kwlyon/physics-demos/torque-spool-demo/output/pdf/torque_spool_physics_walkthrough.pdf

Torque-Spool Demonstration | Physics Walkthrough

## Why Does the Spool Reverse Direction?

A Newton-Euler walkthrough for the spool-paradox demonstration

Tire-on outer diameter: D = 185.0 mm | | | rolling radius: R = 92.5 mm

### 1. System, forces, and sign conventions

A cord is tangent to an inner winding cylinder of radius r while the spool rolls on outer tires of radius R. The cord is pulled with tension T at angle θ above the horizontal. The direction of the spool’s acceleration changes at a critical angle θc.

Take +x to the right, positive angular acceleration α counterclockwise, and let the static-friction force f be signed. The leftward friction arrow below is the direction obtained for the usual geometry; the equations themselves determine its sign.

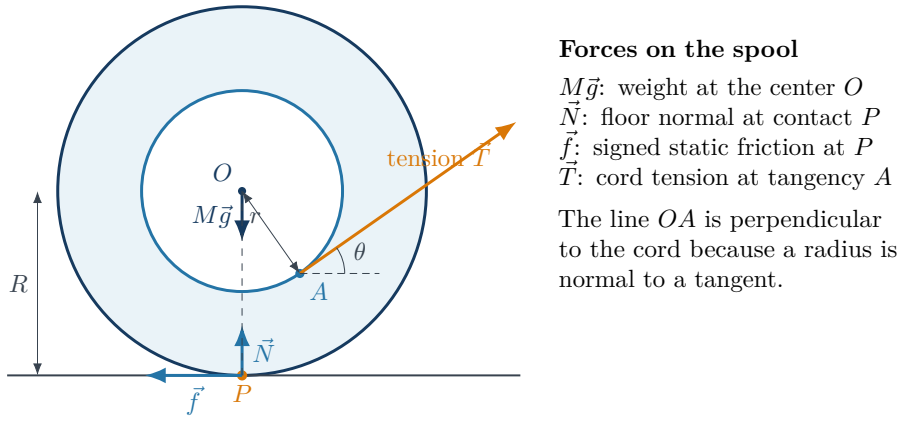
[picture p2: figure]
tension T⃗; Forces on the spool; M⃗g: weight at the center O N⃗ : floor normal at contact P ⃗f: signed static friction at P T⃗: cord tension at tangency A; The line OA is perpendicular to the cord because a radius is normal to a tangent.

Rolling constraint: with the signs chosen above, rolling without slipping requires

a = −Rα.

### 2. Newton’s laws and the rolling acceleration

Let M be the total spool mass and I its moment of inertia about O. Newton’s second law in the horizontal and vertical directions gives

∑︂Fx : | T cos θ + f = M a, | (1)
∑︂Fy : | N + T sin θ − Mg = 0. | (2)

The vertical acceleration is zero while the spool stays on the floor, so

| N = Mg − T sin θ. | (3)

Now sum torques about the center O. The tension is tangent to radius r, and friction acts with lever arm R. With counterclockwise torque positive,

∑︂τO = rT + Rf = Iα. | (4)

Use the rolling condition α = −a/R and solve Eq. (1) for f:

| f = M a − T cos θ.

Substitution into Eq. (4) gives

rT + R (M a − T cos θ) = −

| I R
a,

T (r − R cos θ) + a

(︃

| MR + I R
)︃
| = 0.

Define two dimensionless quantities,

ρ =

r
R
, | κ =
| I MR² .

The acceleration and the signed friction force are then

| a = T M cos θ − ρ 1 + κ | (5)

f = −T

ρ + κ cos θ
1 + κ
. | (6)

Equation (5) contains the reversal directly. Because T /M and 1 + κ are positive, only cos θ − ρ determines the sign of a:

Condition Sign of a | Motion from rest
cos θ > ρ | a > 0 | accelerates toward +x
cos θ = ρ | a = 0 | transition point
cos θ < ρ | a < 0 | accelerates toward −x
a = 0 | =⇒ | cos θc =

r
R

## =⇒ θc = cos⁻¹

(︄

r
R

)︄

### 3. Geometry of the critical angle

The same result has a useful geometric interpretation. At the transition, extend the cord’s line of action backward from the tangency point A. It passes through the floor-contact point P. The tension vector itself still begins at A, its physical point of application.

In right triangle OAP,

OP = R, OA = r.

Since ∠OP A = 90◦ − θc,

r
R

= sin(90◦ − θc) = cos θc.

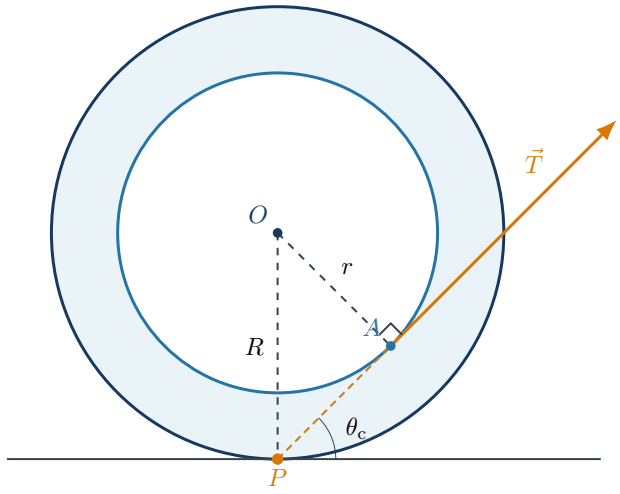
[picture p3: figure]

## θc = cos⁻¹

(︄

r
R

)︄

## = cos⁻¹

⎛
⎝

2r
D

⎞
⎠ .

### 4. Numerical check for the 45-degree insert

For the installed TPU tires,

D = 185.0 mm, R =

D
2

= 92.5 mm.

The 45-degree insert has r = 65.407 mm, so

θc = cos⁻¹

(︃

| 65.407 mm 92.5 mm )︃

= 45.00◦

For cord diameter d, the first-layer centerline radius is

reff = r +

d
2

A 2.0 mm cord gives reff = 66.407 mm and θc,ef f ≈ 44.12◦ .

### 5. Static-friction condition for no slipping

Terminology. The relevant material property is the coefficient of static friction µs. The coefficient of restitution e describes energy retained in an impact or bounce and does not set the rolling-slip threshold in this slow demonstration.

Coulomb static friction requires
|f| ≤ µsN. | (7)

Using Eqs. (3) and (6), the general required coefficient is

µreq(θ) = T |ρ + κ cos θ|
(1 + κ) (Mg − T sin θ)
. | (8)

This formula applies while N > 0, or equivalently T sin θ < Mg.

At the critical angle, ρ = cos θc. The dependence on the moment of inertia cancels:

|fc| = T cos θc, Nc = Mg − T sin θc.

Let the dimensionless pull be q = T /(Mg). The critical-angle slip test becomes

µreq,c =

q cos θc
1 − q sin θc

(9)

q ≤ qmax =

µs
cos θc + µs sin θc
. | (10)

How much do the larger angles matter?

The table uses a representative pull q = 0.20, meaning T = 0.20Mg. It is a dimensionless illustration, not a measurement of the apparatus.

θc | Nc/(Mg) |fc|/(Mg) µreq,c
30◦ | 0.900 | 0.173 0.192
40◦ | 0.871 | 0.153 0.176
45◦ | 0.859 | 0.141 0.165
50◦ | 0.847 | 0.129 0.152
60◦ | 0.827 | 0.100 0.121

From 30◦

to 60◦
, the normal force falls only from 0.900Mg to 0.827Mg (about an 8% change). Meanwhile, the horizontal tension that friction must balance falls more strongly. The required friction coefficient therefore decreases, from about 0.192 to 0.121 in this example. Larger critical angles slightly unload the tire, but they do not make slip more likely here; the friction margin improves.

For any planned pull, compute q = T /(Mg) and compare Eq. (9) with the available µs, or use
Eq. (10) to find the largest no-slip pull.

### 6. Suggested classroom procedure

1. Install the desired insert and both TPU tires. Use a thin cord in one neat layer.
2. Measure the spool mass M and, if quantitative testing is desired, measure the pull T with a spring scale or force sensor.
3. Pull slowly at an angle clearly below the label and note the acceleration direction.
4. Repeat clearly above the label and observe the reversal.
5. Approach the transition in small angular steps. Compare the result with

θc = cos⁻¹

(︃

r
R

)︃
,

or replace r by r + d/2 when correcting for cord thickness.

6. Evaluate the no-slip margin using

q =

T
Mg
, | µreq,c =

q cos θc
1 − q sin θc

7. Discuss why taking torques about the floor-contact point gives the same critical-angle condition: the normal force, friction, and weight all have zero moment about that point at the transition, and the tension line passes through it.

### 7. Model assumptions and interpretation

- The spool is rigid, the floor is level, and the cord stays taut and tangent to the winding cylinder.
- The no-slip derivation uses static friction and the rolling constraint a = −Rα.
- The cord is treated as massless. Additional winding layers increase the effective radius and lower the critical angle.
- Axle losses, rolling resistance, tire deformation, and three-dimensional misalignment are neglected.
- The sign of the acceleration predicts the initial rolling direction. Exactly at the ideal transition, the tension produces no rolling acceleration; small losses and imperfections can dominate.

Central result: Newton’s laws, the rolling constraint, and the tangent geometry all lead to

θc = cos⁻¹

(︃

r
R

)︃

The static-friction test is separate: it checks whether the assumed rolling motion can occur without slipping.

Dimensions correspond to the supplied spool with both TPU tires installed.
