kwlyon/physics-demos/torque-spool-demo/renders/01_original_spool_with_tires.png

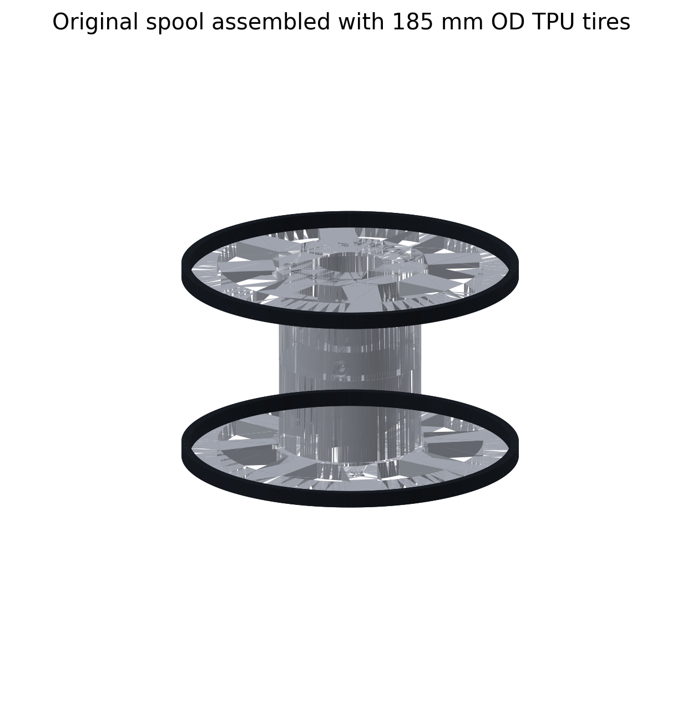
torque-spool-demo/renders/01_original_spool_with_tires.png
