kwlyon/physics-demos/torque-spool-demo/renders/02_insert_fitted_to_spool.png

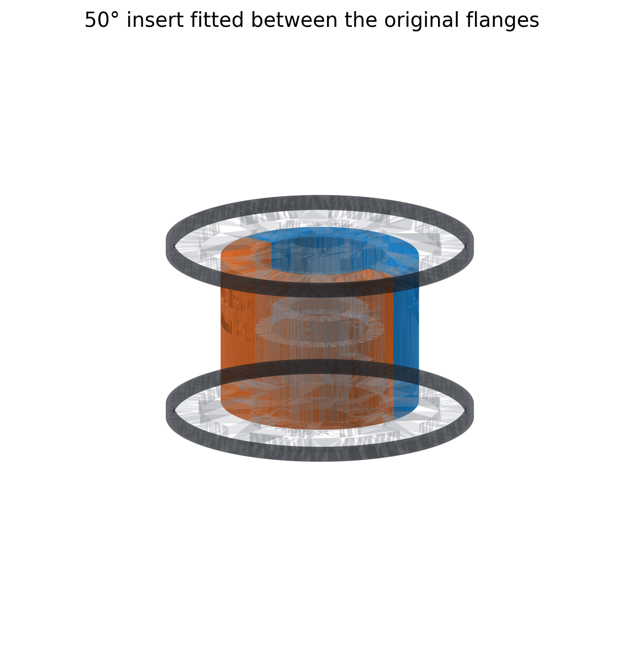
torque-spool-demo/renders/02_insert_fitted_to_spool.png
