kwlyon/physics-demos/torque-spool-demo/renders/03_halves_separated_plugs.png

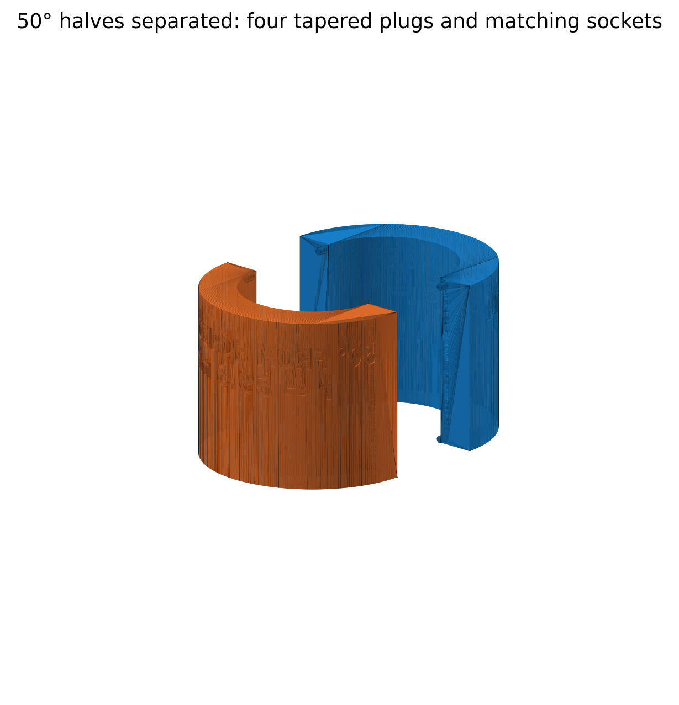
torque-spool-demo/renders/03_halves_separated_plugs.png
