kwlyon/physics-demos/torque-spool-demo/renders/04_string_anchor_closeup.png

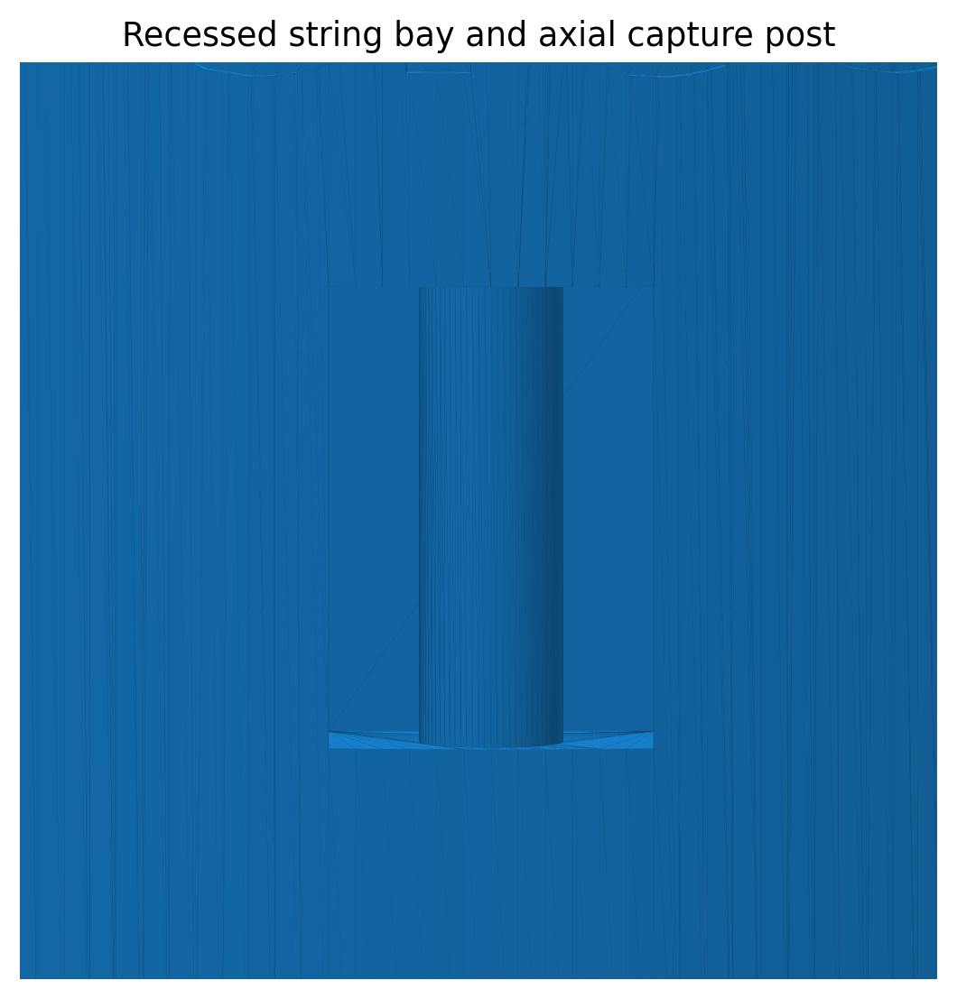
torque-spool-demo/renders/04_string_anchor_closeup.png
