kwlyon/physics-demos/torque-spool-demo/renders/05_engraved_label_closeup.png

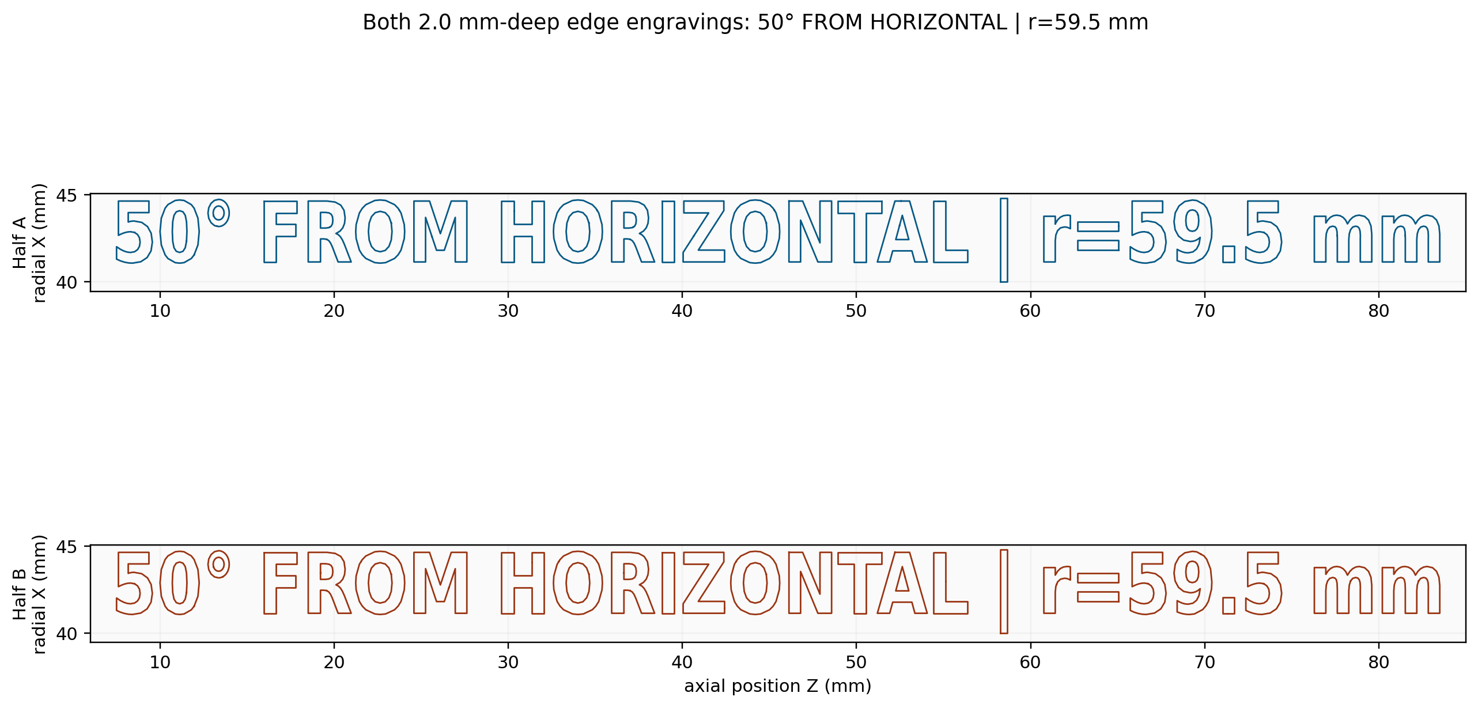
torque-spool-demo/renders/05_engraved_label_closeup.png
