kwlyon/physics-demos/torque-spool-demo/renders/07_sectional_fit.png

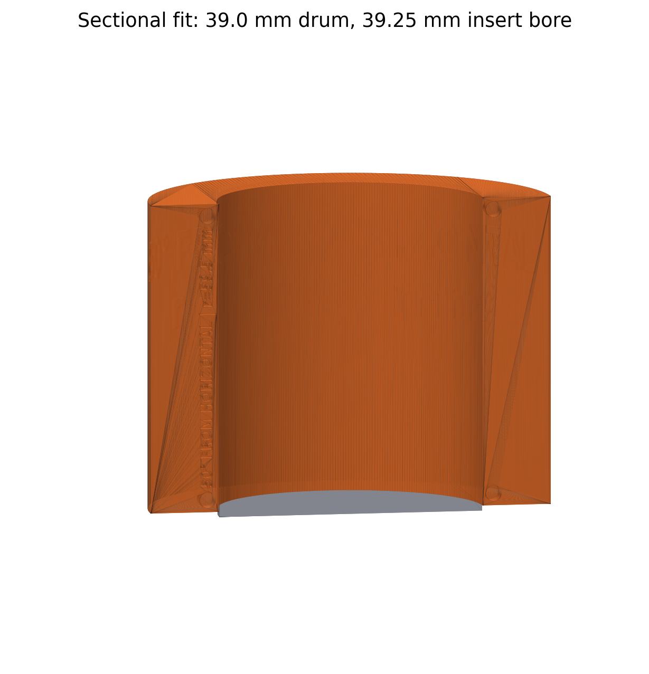
torque-spool-demo/renders/07_sectional_fit.png
