kwlyon/physics-demos/torque-spool-demo/renders/08_outer_labels_unwrapped.png

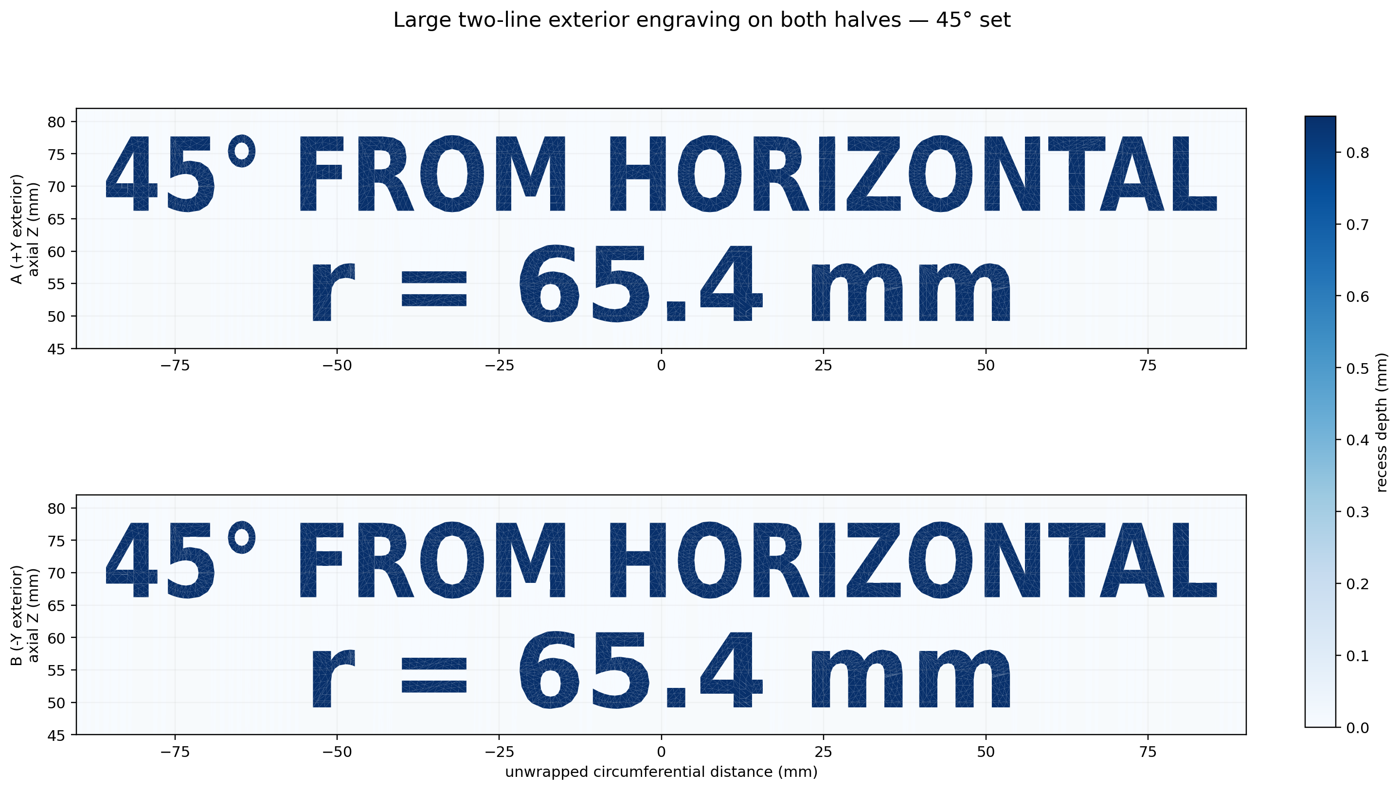
torque-spool-demo/renders/08_outer_labels_unwrapped.png
