kwlyon/physics-demos/torque-spool-demo/renders/09_low_profile_rope_hooks.png

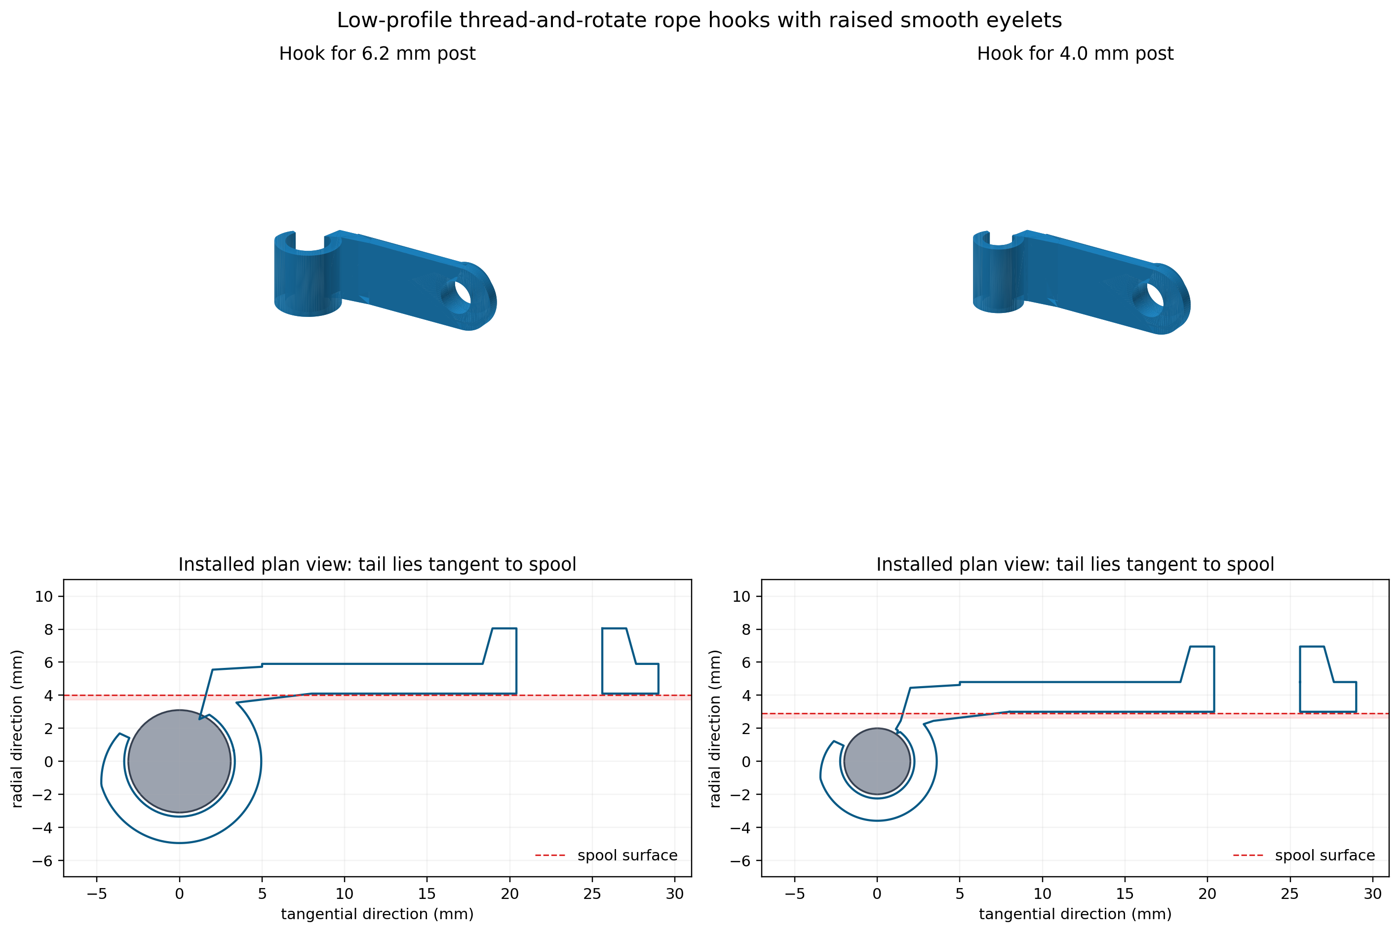
torque-spool-demo/renders/09_low_profile_rope_hooks.png
