kwlyon/physics-demos/torque-spool-demo/renders/axle_bore_clamp_plugs.png

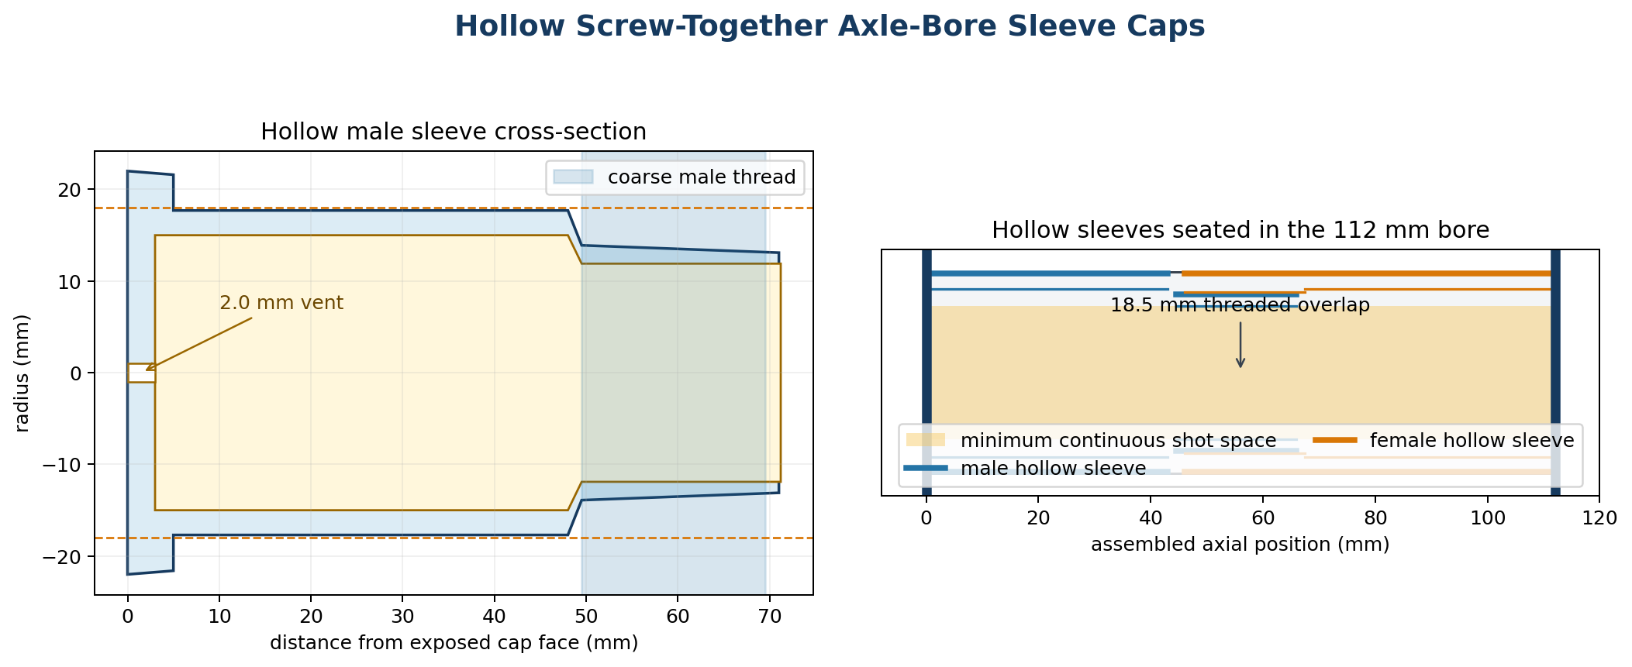
torque-spool-demo/renders/axle_bore_clamp_plugs.png
