kwlyon/physics-demos/torque-spool-demo/source_anchor_closeup.png

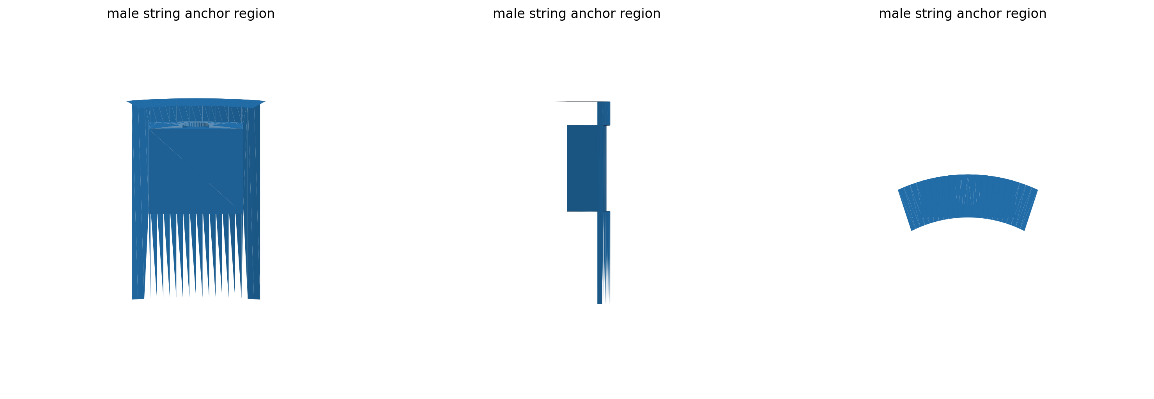
torque-spool-demo/source_anchor_closeup.png
