kwlyon/physics-demos/torque-spool-demo/source_anchor_sections.png

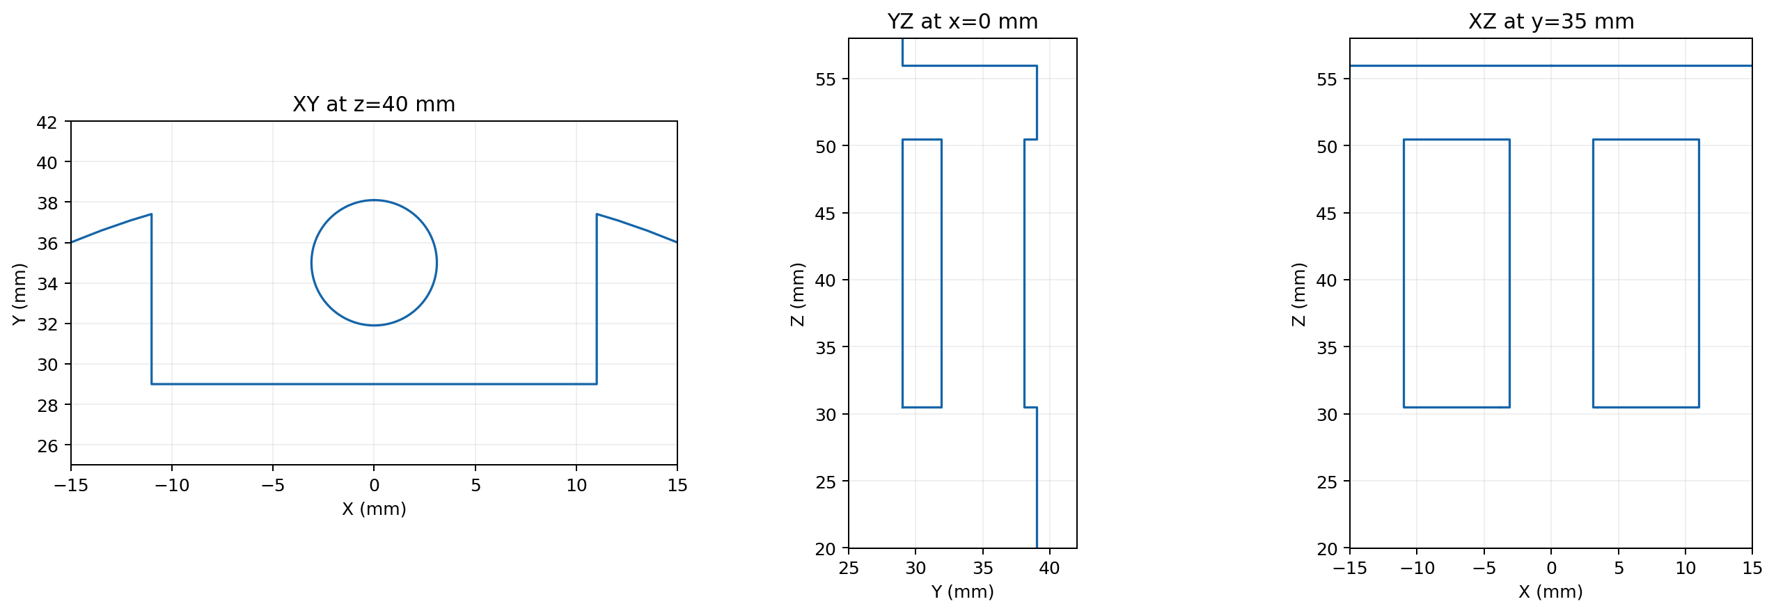
torque-spool-demo/source_anchor_sections.png
