kwlyon/physics-demos/torque-spool-demo/source_core_closeups.png

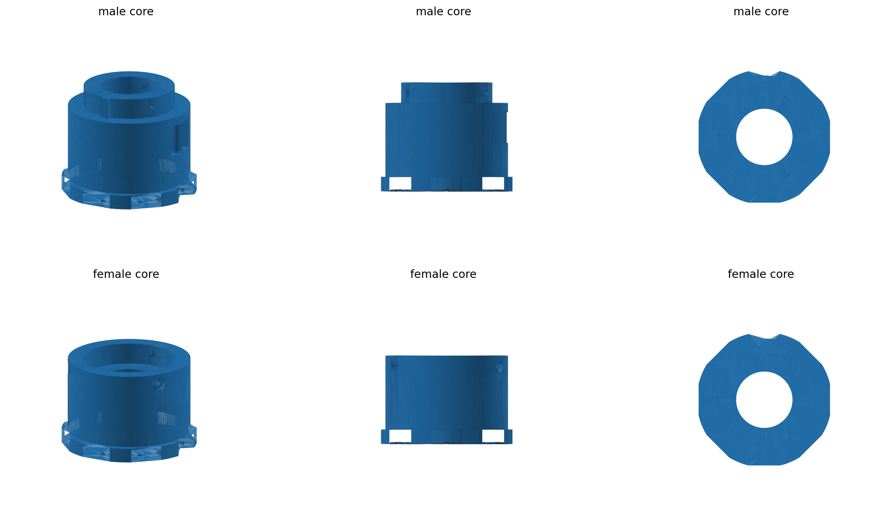
torque-spool-demo/source_core_closeups.png
