kwlyon/physics-demos/torque-spool-demo/Axle_Bore_Clamp_Plug_FEMALE_print_1x.stl

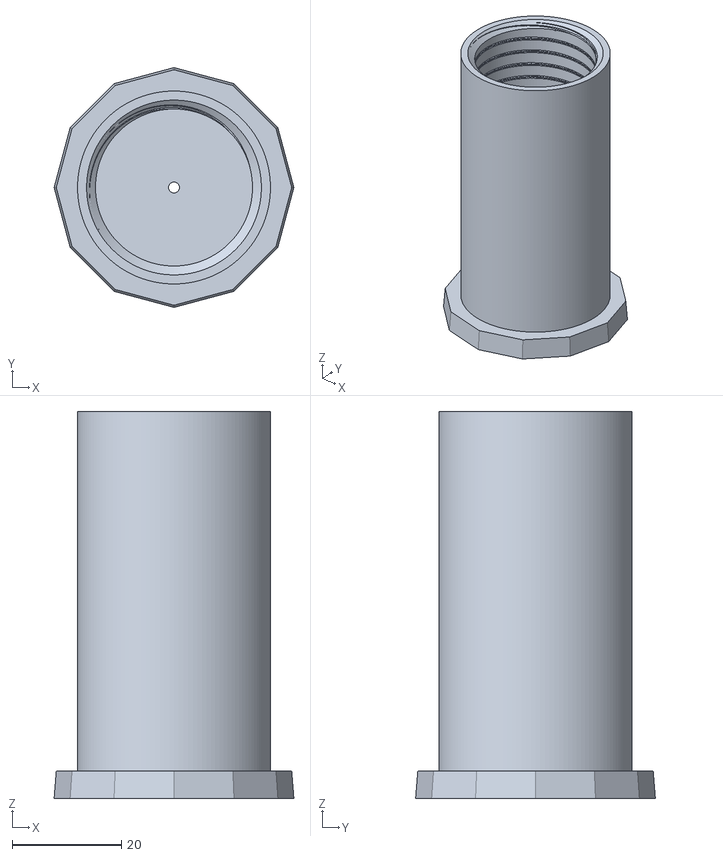
[picture p16: CAD file, 2026-10-16]
torque-spool-demo/Axle_Bore_Clamp_Plug_FEMALE_print_1x.stl
44.0 x 44.0 x 71.0
