kwlyon/physics-demos/torque-spool-demo/Spool_Paradox_Bambu_Print_Kit/Optional_TPU_tire_print_2x.stl

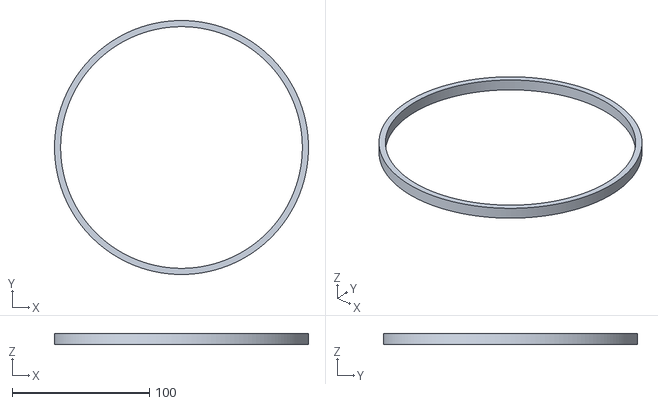
[picture p17: CAD file, 2026-10-16]
torque-spool-demo/Spool_Paradox_Bambu_Print_Kit/Optional_TPU_tire_print_2x.stl
185.0 x 185.0 x 8.00
