kwlyon/physics-demos/torque-spool-demo/Spool_Insert_60deg_A.stl

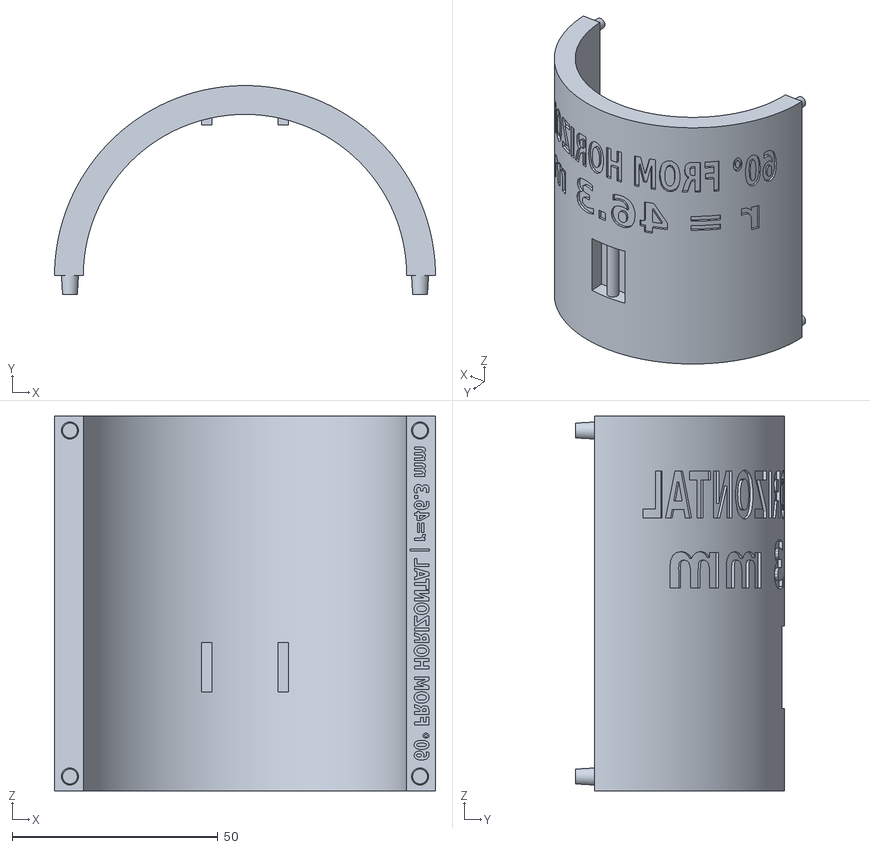
[picture p20: CAD file, 2026-10-16]
torque-spool-demo/Spool_Insert_60deg_A.stl
92.5 x 50.7 x 91.0
