kwlyon/physics-demos/torque-spool-demo/Spool_Paradox_Bambu_Print_Kit/Spool_MALE_print_1x.stl

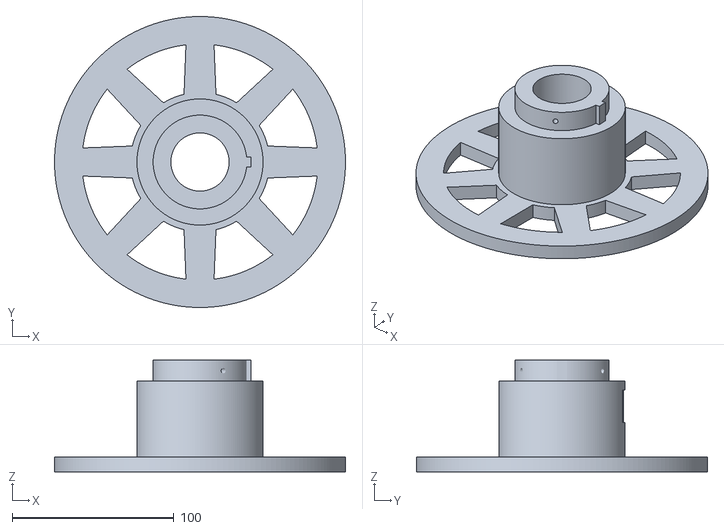
[picture p21: CAD file, 2026-10-16]
torque-spool-demo/Spool_Paradox_Bambu_Print_Kit/Spool_MALE_print_1x.stl
180.0 x 180.0 x 69.0
