kwlyon/physics-demos/torque-spool-demo/Low_Profile_Rope_Hook_6p2mm_Post.stl

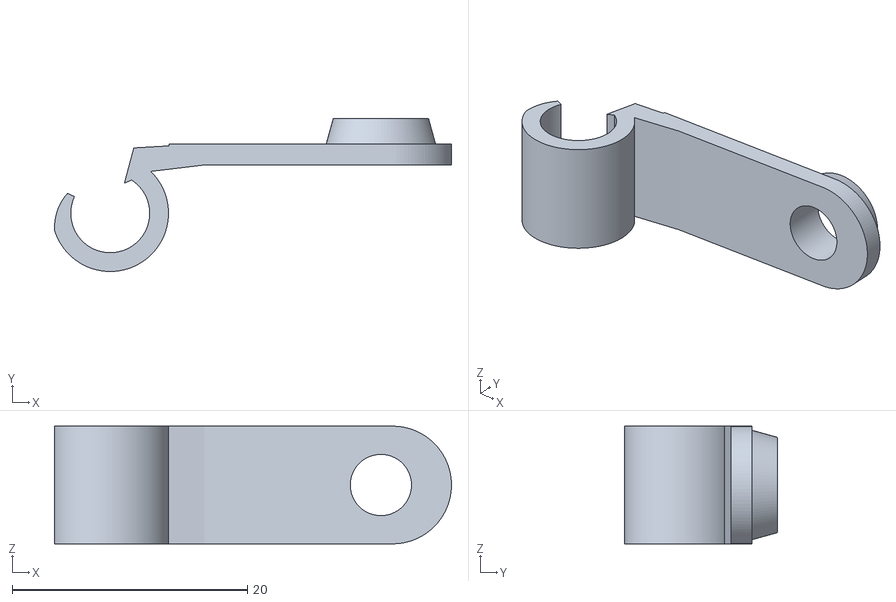
[picture p22: CAD file, 2026-10-16]
torque-spool-demo/Low_Profile_Rope_Hook_6p2mm_Post.stl
33.7 x 13.0 x 10.0
