kwlyon/physics-demos/torque-spool-demo/Spool_Insert_45deg_A.stl

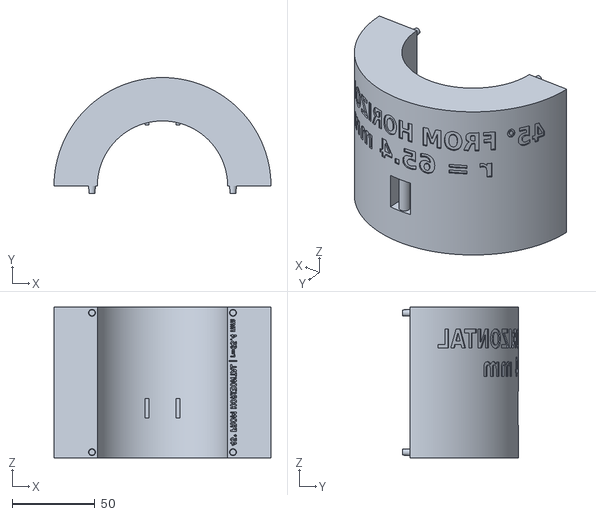
[picture p23: CAD file, 2026-10-16]
torque-spool-demo/Spool_Insert_45deg_A.stl
130.8 x 69.9 x 91.0
