kwlyon/physics-demos/torque-spool-demo/Spool_Insert_30deg_A.stl

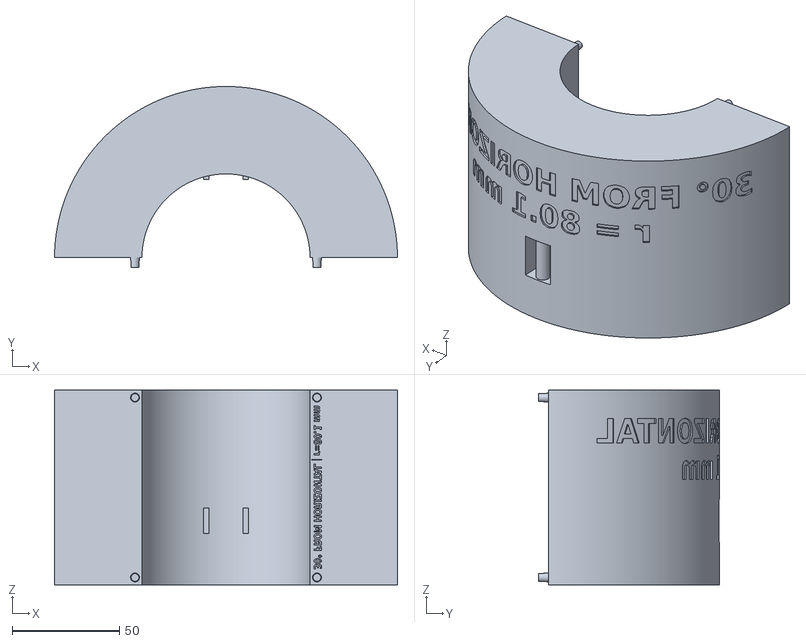
[picture p24: CAD file, 2026-10-16]
torque-spool-demo/Spool_Insert_30deg_A.stl
160.2 x 84.6 x 91.0
