kwlyon/physics-demos/torque-spool-demo/Spool_Insert_40deg_B.stl

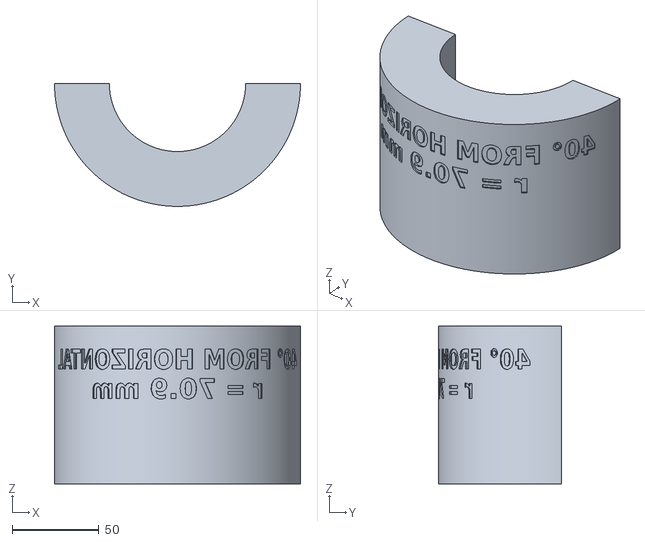
[picture p25: CAD file, 2026-10-16]
torque-spool-demo/Spool_Insert_40deg_B.stl
141.7 x 70.7 x 91.0
