kwlyon/physics-demos/torque-spool-demo/Spool_Insert_45deg_B.stl

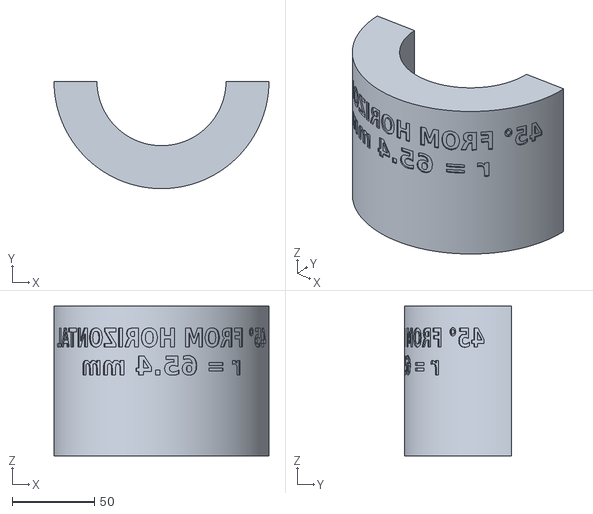
[picture p26: CAD file, 2026-10-16]
torque-spool-demo/Spool_Insert_45deg_B.stl
130.8 x 65.3 x 91.0
