kwlyon/physics-demos/torque-spool-demo/Spool_Insert_30deg_B.stl

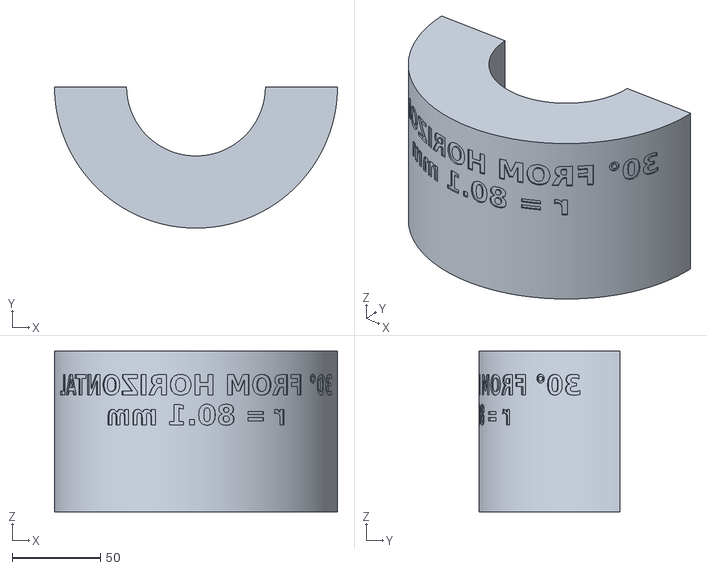
[picture p27: CAD file, 2026-10-16]
torque-spool-demo/Spool_Insert_30deg_B.stl
160.2 x 80.0 x 91.0
