kwlyon/physics-demos/torque-spool-demo/Spool_Insert_60deg_B.stl

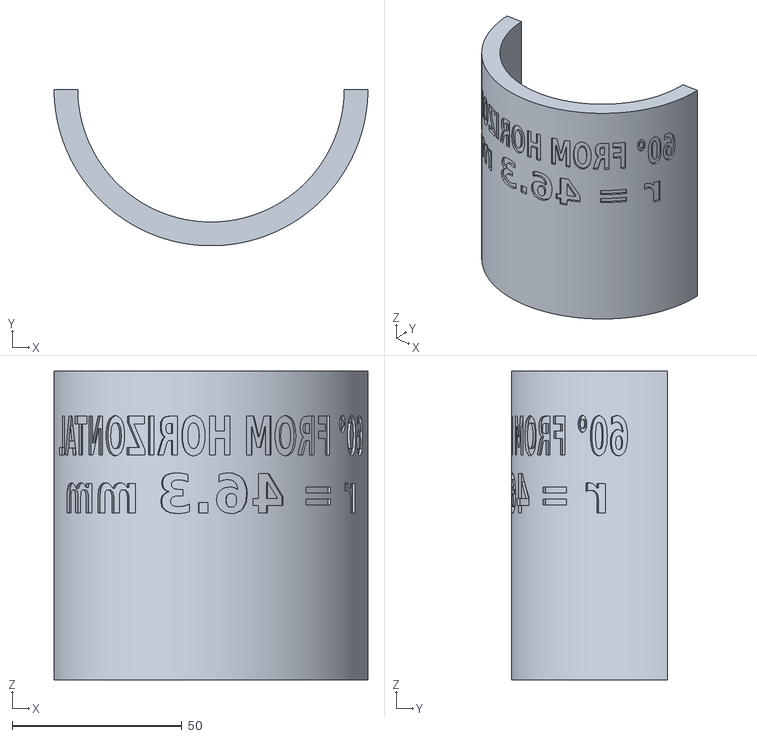
[picture p28: CAD file, 2026-10-16]
torque-spool-demo/Spool_Insert_60deg_B.stl
92.5 x 46.1 x 91.0
