kwlyon/physics-demos/torque-spool-demo/Spool_Insert_50deg_B.stl

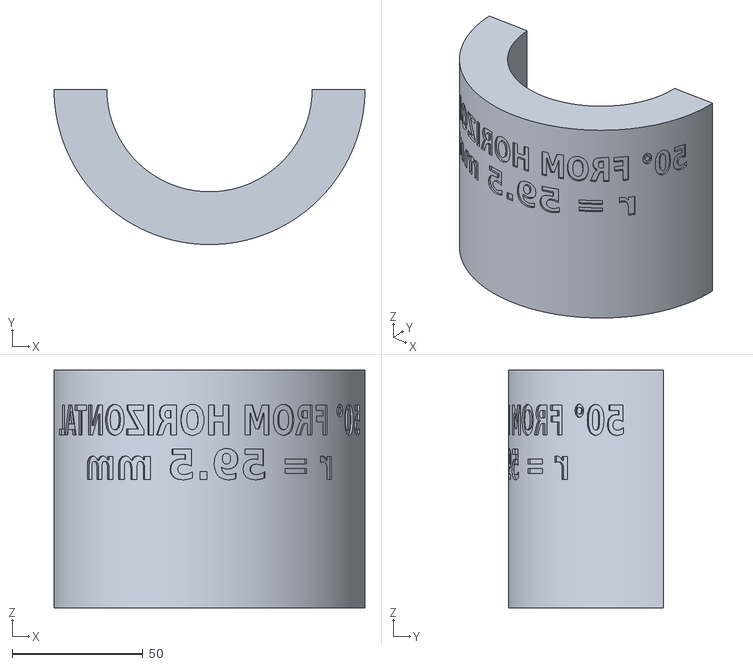
[picture p29: CAD file, 2026-10-16]
torque-spool-demo/Spool_Insert_50deg_B.stl
118.9 x 59.3 x 91.0
