kwlyon/physics-demos/torque-spool-demo/Spool_Insert_40deg_A.stl

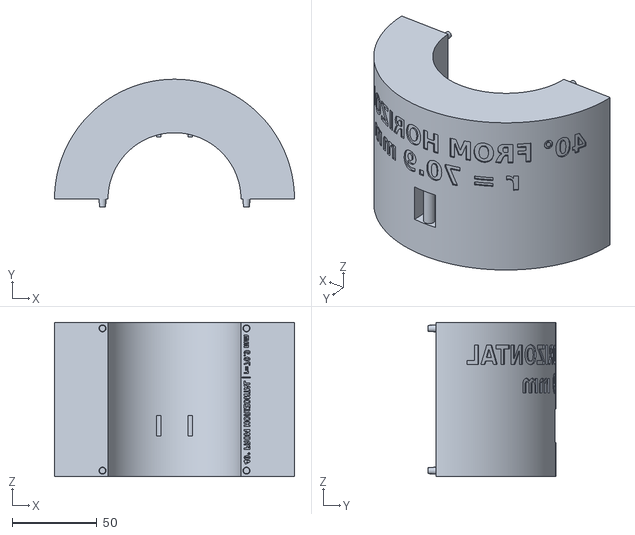
[picture p30: CAD file, 2026-10-16]
torque-spool-demo/Spool_Insert_40deg_A.stl
141.7 x 75.3 x 91.0
