kwlyon/physics-demos/torque-spool-demo/Spool_Insert_50deg_A.stl

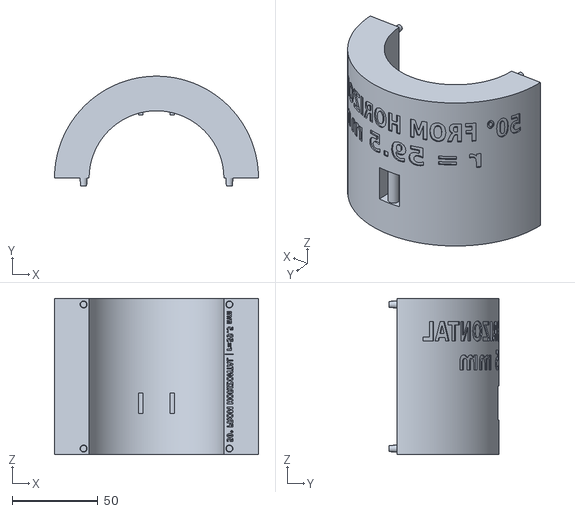
[picture p31: CAD file, 2026-10-16]
torque-spool-demo/Spool_Insert_50deg_A.stl
118.9 x 63.9 x 91.0
