kwlyon/physics-demos/torque-spool-demo/Low_Profile_Rope_Hook_4p0mm_Post.stl

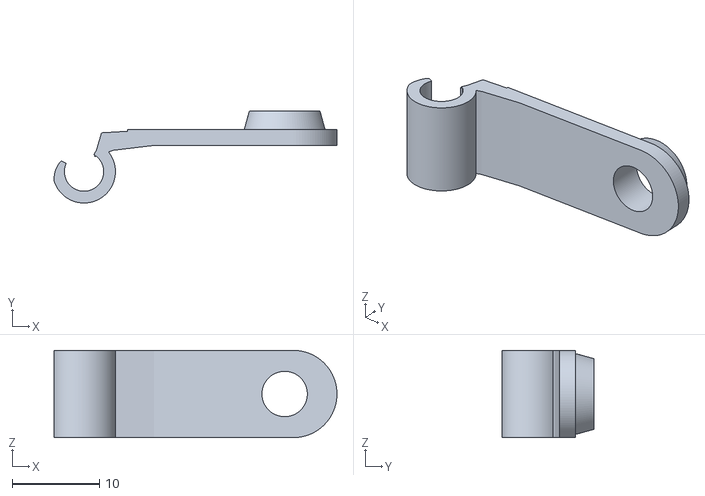
[picture p32: CAD file, 2026-10-16]
torque-spool-demo/Low_Profile_Rope_Hook_4p0mm_Post.stl
32.4 x 10.5 x 10.0
