kwlyon/physics-demos/torque-spool-demo/source_mesh_montage.png

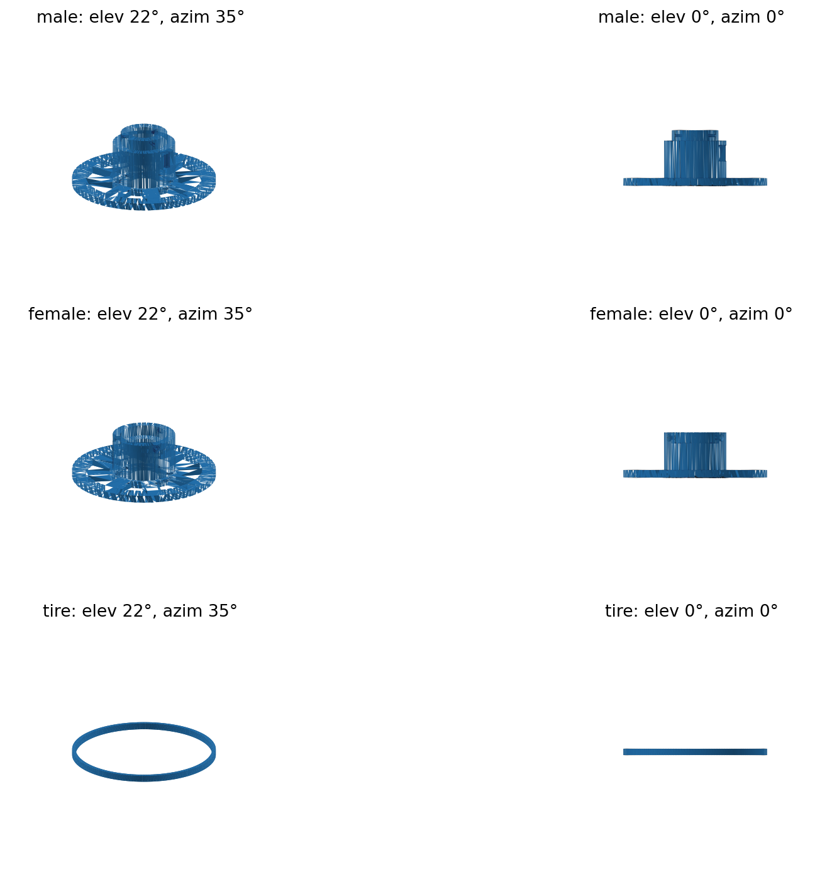
torque-spool-demo/source_mesh_montage.png
