kwlyon/physics-demos/torque-spool-demo/Spool_Paradox_Bambu_Print_Kit/Spool_assembled_preview.png

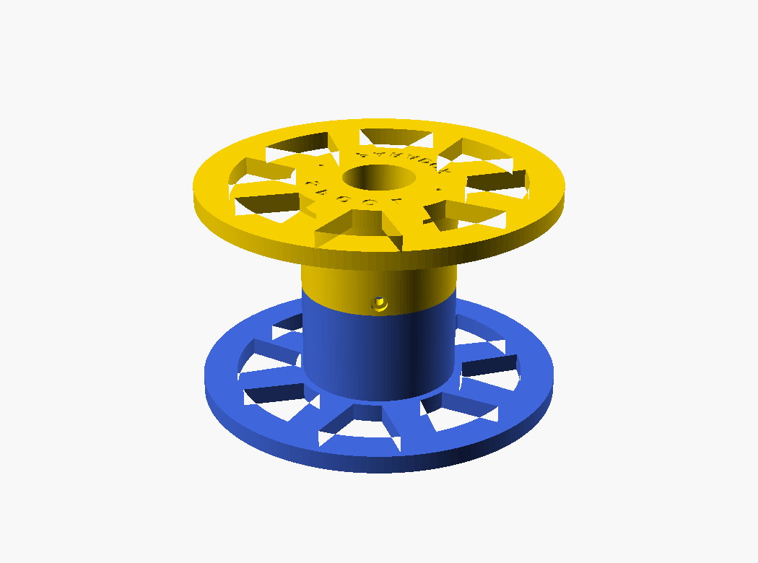
torque-spool-demo/Spool_Paradox_Bambu_Print_Kit/Spool_assembled_preview.png
