kwlyon/physics-demos/(commit log)

2026-10-16 Add torque spool physics demonstration
    [Low_Profile_Rope_Hook_4p0mm_Post.stl, Low_Profile_Rope_Hook_6p2mm_Post.stl, Optional_TPU_tire_print_2x.stl, Spool_FEMALE_print_1x.stl, Spool_Insert_30deg_A.stl, Spool_Insert_30deg_B.stl, Spool_Insert_40deg_A.stl, Spool_Insert_40deg_B.stl]
2026-10-16 Add critical angle calculation to torque spool README
2026-10-16 Render torque spool equations with LaTeX
2026-10-16 Add illustrated torque spool physics handout
2026-10-16 Expand torque spool dynamics and slip analysis
2026-10-16 Add screw-together axle bore clamp plugs
    [Axle_Bore_Clamp_Plugs_print_1set.stl]
2026-10-16 Redesign axle plugs as hollow threaded sleeves
    [Axle_Bore_Clamp_Plugs_print_1set.stl]
2026-10-16 Split axle caps and add resin vents
    [Axle_Bore_Clamp_Plug_FEMALE_print_1x.stl, Axle_Bore_Clamp_Plug_MALE_print_1x.stl, Axle_Bore_Clamp_Plugs_print_1set.stl]
